daniw/xlr_pegelwandler/README.md

xlr_pegelwandler
================

Pegelwandler für den Anschluss von Tastern via XLR
