daniw/xlr_pegelwandler/doc/circuit.tex

% coding:utf-8

\section{Schaltung}

\subsection{Schema}
\begin{figure}[h!]
	\centering
	
	\caption{Schema}
	\label{sch:pegw}
\end{figure}

\subsection{Funktion}
Die beiden Kanäle sind identisch aufgebaut. Nachfolgend wird die Funktionsweise 
anhand der Teilschaltung 10x gezeigt. 

R101 fungiert als Pull-Up Widerstand. Um Störungen durch das lange Kabel des an 
CON101 angeschlossenen Tasters zu verringern ist dieser niederohmig 
ausgeführt. C101 filtert hochfrequente Störungen und stellt einen gewissen 
Schutz der Basis von V101 gegen ESD dar. V101 und V102 arbeiten als Schalter in 
Emitterschaltung. Im Ruhezustand sperren beide Transistoren. Das Ausgangssignal 
ist HIGH. Wird der Taster gedrückt, sinkt die Spannung am Eingang der 
Schaltung. Dadurch wird V101 leitend die Spannung am Kollektor von V101 steigt. 
Dies bewirkt, dass V102 leitend wird und die Ausgangsspannung LOW wird. Beim 
Loslassen des Tasters kehrt die Schaltung in ihren Ursprungszustand zurück. 

\subsubsection{Dimensionierung}
\[ \begin{array}{l}
R101 = \dfrac{U_B}{I_{sw}}\\
U_B = 6.6 V\\
I_{sw} = 20 mA\\
\Rightarrow R101 = \dfrac{6.6V}{20mA} = \underline{\underline{330 \Omega}}
\end{array} \]
\[ \begin{array}{l}
P_{R101} = \dfrac{{U_{R101}}^2}{R101} = \dfrac{{U_{Bat_{max}}}^2}{R101} 
= \dfrac{7.3 V}{330 \Omega} = 161 mW
\end{array} \]
Die Leistung an $R101$ ist am grössten, da die anderen Widerstände um 
Grössenordnungen hochohmiger sind. Für $R101$ wird ein SMD Widerstand der 
Baugrösse 1206 verwendet. Für alle anderen Widerstände genügt die Baugrösse 
0805. 
%
\[ \begin{array}{l}
R104 = \dfrac{5 V - U_{O_H}}{I_O} = \dfrac{5 V - 3 V}{0.2 mA} 
= \underline{\underline{10 k \Omega}}\\
\end{array} \]
%
\[ \begin{array}{l}
I_{B_{V102}} 
= \dfrac{I_{C_{V102}} \cdot ü}{\beta} 
= \dfrac{\dfrac{U_{cc} - U_{CE_{V102}}}{R104} \cdot ü}{\beta_{V102_{min}}} 
= \dfrac{\dfrac{5V - 0.2V}{10 k\Omega} \cdot 3}{110} = 11.73 \mu A\\\\
R103_{max} 
= \dfrac{U_{B_{min}} - U_{CE_{V101}} - U_{BE_{V102}}}{I_{B_{V102}}} 
= \dfrac{5 V - 0.2 V - 0.7 V}{11.73 \mu A} 
= 349.6 k \Omega\\\\
\rightarrow \underline{\underline{330 k\Omega}}
\end{array} \]
%
Für die Dimensionierung von $R105$ wird der Basisstrom vom $V102$ 
vernachlässigt. Als Kollektorstrom $I_{C_{V101}}$ werden $0.2 mA$ festgelegt. 
\[ \begin{array}{l}
R105_{max} 
= \dfrac{U_{B_{min}} - U_{CE_{V101}}}{I_{C_{V101}}} 
= \dfrac{5 V - 0.2 V}{0.2 mA} = \underline{\underline{24 k \Omega}}\\
\end{array} \]
%
\[ \begin{array}{l}
R102 
= \dfrac{U_{B_{min}} - U_{BE_{V101}}}{I_{B_{V101}}}\\\\
I_{B_{V101}} 
= \dfrac{I_{C_{V101}} \cdot ü}{\beta}\\\\
I_{C_{V101}} 
= I_{R105} + I_{R103} 
= \dfrac{U_{B_{min}} - U_{CE_{V101}}}{R105} 
+ \dfrac{U_{B_{min}} - U_{CE_{V101}} - U_{BE_{V102}}}{R103} \\\\
= \dfrac{5 V - 0.2 V}{24 k \Omega} + \dfrac{5 V - 0.2 V - 0.7 V}{330 k \Omega} 
= 0.2 mA + 12.42 \mu A 
= 212.42 \mu A \\\\
I_{B_{V101}} 
= \dfrac{212.42 \mu A \cdot 3}{125} 
= 5.098 \mu A \\\\
R102_{max} 
= \dfrac{5 V - 0.7 V}{0.298 \mu A} 
= 843.4 k \Omega 
\rightarrow \underline{\underline{820 k \Omega}}
\end{array} \]
%
$C101$ dient dazu, Störungen zu reduzieren. Dazu bildet er mit $R101$ zusammen 
einen Tiefpass. $R102$ kann für diese Betrachtung vernachlässigt werden. Als 
Grenzfrequenz $f_g$ wird willkürlich ein Wert von $5 kHz$ angenommen. 
\[ f_g = \dfrac{1}{2 \cdot \pi \cdot R101 \cdot C101} \]
\[ C101 = \dfrac{1}{2 \cdot \pi \cdot R101 \cdot f_g} 
= C101 = \dfrac{1}{2 \cdot \pi \cdot 330 \Omega \cdot 5 kHz} = 96.56 nF 
\rightarrow \underline{\underline{100 nF}} \]
