daniw/xlr_pegelwandler/doc/xlr_pegelwandler_main.tex

% coding:utf-8

%FOSAET, a LaTeX-Code for a electrical summary of basic electronics
%Copyright (C) 2013, Daniel Winz, Ervin Mazlagic

%This program is free software; you can redistribute it and/or
%modify it under the terms of the GNU General Public License
%as published by the Free Software Foundation; either version 2
%of the License, or (at your option) any later version.

%This program is distributed in the hope that it will be useful,
%but WITHOUT ANY WARRANTY; without even the implied warranty of
%MERCHANTABILITY or FITNESS FOR A PARTICULAR PURPOSE.  See the
%GNU General Public License for more details.
%----------------------------------------

\documentclass[a4paper,10pt,fleqn]{article}

\usepackage{xlr_pegelwandler_layout}

\title{Dokumentation XLR-Pegelwandler}

\author{Daniel Winz}
\date{\today~\dtc}

\begin{document}

\maketitle
\newpage
% \include{about}

\tableofcontents

\include{requirements}
\include{circuit}
\include{layout}
\include{bom}
\include{bestueck}
\include{test}

\end{document}
