daniw/xlr_pegelwandler/doc/bom.tex

% coding:utf-8

\section{Stückliste}

\subsection{Stückliste für eine Platine}
\STautoround*{2}
\begin{table}[h!]
  \begin{spreadtab}{{tabular}{@{}l@{}lllrr}}
    @ & @ Anzahl  & @ Bezeichnung & @ Bestellnummer & @ Einzelpreis & @ Gesamtpreis \\
    @ & @ \lbrack Stk\rbrack && @ (Distrelec) & @ \lbrack Fr.\rbrack & @ \lbrack Fr.\rbrack \\
    @ \rowcolor{lgray} & 1 & @ Platine                       & @          & 4.536& \STcopy{v}{b3*[-1,0]}\\
    @ \rowcolor{white} & 1 & @ Neutrik NC3MD-V               & @ 15 98 55 & 8.30 &  \\
    @ \rowcolor{lgray} & 2 & @ BC847A                        & @ 61 03 79 & 0.29 &  \\
    @ \rowcolor{white} & 2 & @ BC857A                        & @ 61 15 88 & 0.27 &  \\
    @ \rowcolor{lgray} & 2 & @ Widerstand 330 $\Omega$ 1206  & @ 71 12 86 & 0.089&  \\
    @ \rowcolor{white} & 2 & @ Widerstand 10 k$\Omega$ 0805  & @ 71 33 18 & 0.069&  \\
    @ \rowcolor{lgray} & 2 & @ Widerstand 24 k$\Omega$ 0805  & @ 71 33 27 & 0.069&  \\
    @ \rowcolor{white} & 2 & @ Widerstand 330 k$\Omega$ 0805 & @ 71 33 54 & 0.069&  \\
    @ \rowcolor{lgray} & 2 & @ Widerstand 820 k$\Omega$ 0805 & @ 71 33 64 & 0.069&  \\
    @ \rowcolor{white} & 2 & @ Kondensator 100 nF 0805       & @ 83 14 69 & 0.15 &  \\
    @ \rowcolor{lgray} & 1 & @ Stiftleiste Dubox 5p Pol      & @ 11 67 33 & 1.70 &  \\
    @ \rowcolor{white} & 1 & @ Buchsengehäuse Dubox 5 Pol    & @ 11 67 03 & 1.10 &  \\
    @ \rowcolor{lgray} & 5 & @ Crimpkontakt Dubox            & @ 11 67 29 & 0.70 &  \\
    @ \rowcolor{white} & 2 & @ Senkkopfschraube M3 x 12      & @ 34 32 38 & 0.185 &  \\
    @ \rowcolor{lgray} & 2 & @ Mutter M3                     & @ 34 82 75 & 0.153&  \\
    @ \rowcolor{white} & 2 & @ Fächerscheibe für M3          & @ 34 82 48 & 0.098&  \\&&&&\\
    @ \rowcolor{white} &   & @ Total                         & @          &      & :={sum(f3:[0,-2])}\\
    \cline{6-6}
    \cline{6-6}
  \end{spreadtab}
\end{table}

\newpage
\subsection{Stückliste für gesamtes Gerät}
% Diese Stückliste ist die Empfehlung für die Bestellung. 
% Dabei sind Reserven für SMD-Bauteile und die Crimpkontakte berücksichtigt. \\
% Auch in dieser Stückliste ist das Gehäuse nur ein Vorschlag, da die benötigten 
% Abmessungen nicht bekannt sind. 
\STautoround*{2}
\begin{table}[h!]
  \begin{spreadtab}{{tabular}{@{}l@{}lllrr}}
    @ & @ Anzahl  & @ Bezeichnung & @ Bestellnummer & @ Einzelpreis & @ Gesamtpreis \\
    @ & @ \lbrack Stk\rbrack && @ (Distrelec) & @ \lbrack Fr.\rbrack & @ \lbrack Fr.\rbrack \\
    @ \rowcolor{lgray} & 1 & @ Gehäuse Fibox ABS100/75 LT    & @ 30 29 93 & 12.10& \STcopy{v}{b3*[-1,0]}\\
    @ \rowcolor{white} & 2 & @ Platine                       & @          & 4.536&  \\
    @ \rowcolor{lgray} & 2 & @ Neutrik NC3MD-V               & @ 15 98 55 & 8.30 &  \\
    @ \rowcolor{white} & 5 & @ BC847A                        & @ 61 03 79 & 0.29 &  \\
    @ \rowcolor{lgray} & 5 & @ BC857A                        & @ 61 15 88 & 0.27 &  \\
    @ \rowcolor{white} & 5 & @ Widerstand 330 $\Omega$ 1206  & @ 71 12 86 & 0.089&  \\
    @ \rowcolor{lgray} & 5 & @ Widerstand 10 k$\Omega$ 0805  & @ 71 33 18 & 0.069&  \\
    @ \rowcolor{white} & 5 & @ Widerstand 24 k$\Omega$ 0805  & @ 71 33 27 & 0.069&  \\
    @ \rowcolor{lgray} & 5 & @ Widerstand 330 k$\Omega$ 0805 & @ 71 33 54 & 0.069&  \\
    @ \rowcolor{white} & 5 & @ Widerstand 820 k$\Omega$ 0805 & @ 71 33 64 & 0.069&  \\
    @ \rowcolor{lgray} & 5 & @ Kondensator 100 nF 0805       & @ 83 14 69 & 0.15 &  \\
    @ \rowcolor{white} & 2 & @ Stiftleiste Dubox 5p Pol      & @ 11 67 33 & 1.70 &  \\
    @ \rowcolor{lgray} & 2 & @ Buchsengehäuse Dubox 5 Pol    & @ 11 67 03 & 1.10 &  \\
    @ \rowcolor{white} &15 & @ Crimpkontakt Dubox            & @ 11 67 29 & 0.70 &  \\
    @ \rowcolor{lgray} & 4 & @ Senkkopfschraube M3 x 12      & @ 34 32 38 & 0.185 &  \\
    @ \rowcolor{white} & 4 & @ Mutter M3                     & @ 34 82 75 & 0.153&  \\
    @ \rowcolor{lgray} & 4 & @ Fächerscheibe für M3          & @ 34 82 48 & 0.098&  \\&&&&\\
    @ \rowcolor{white} &   & @ Total                         & @          &      & :={sum(f3:[0,-2])}\\
    \cline{6-6}
    \cline{6-6}
  \end{spreadtab}
\end{table}
