daniw/xlr_pegelwandler/doc/fig/xlr_pegelwandler_v_1_2_best_eagle.pdf

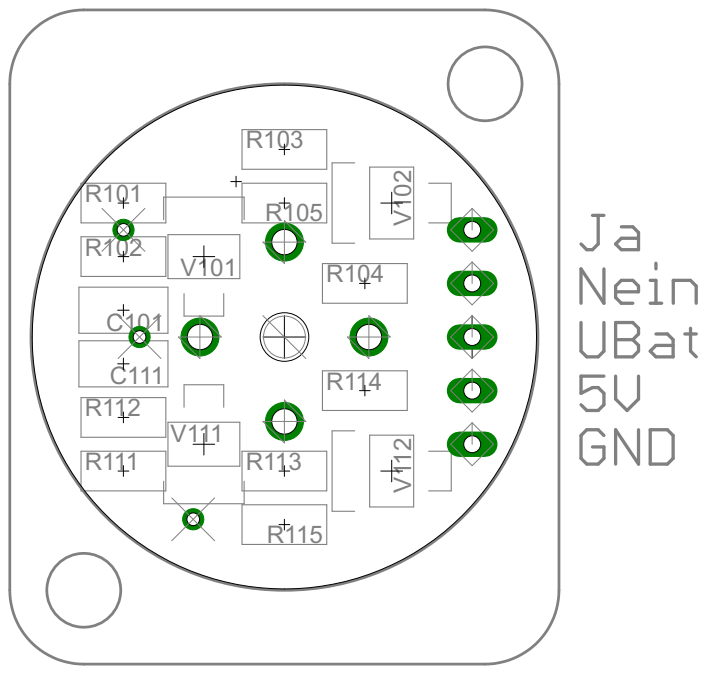
[picture p1: page 1]
