daniw/xlr_pegelwandler/doc/fig/xlr_pegelwandler_v_1_2_lay.pdf

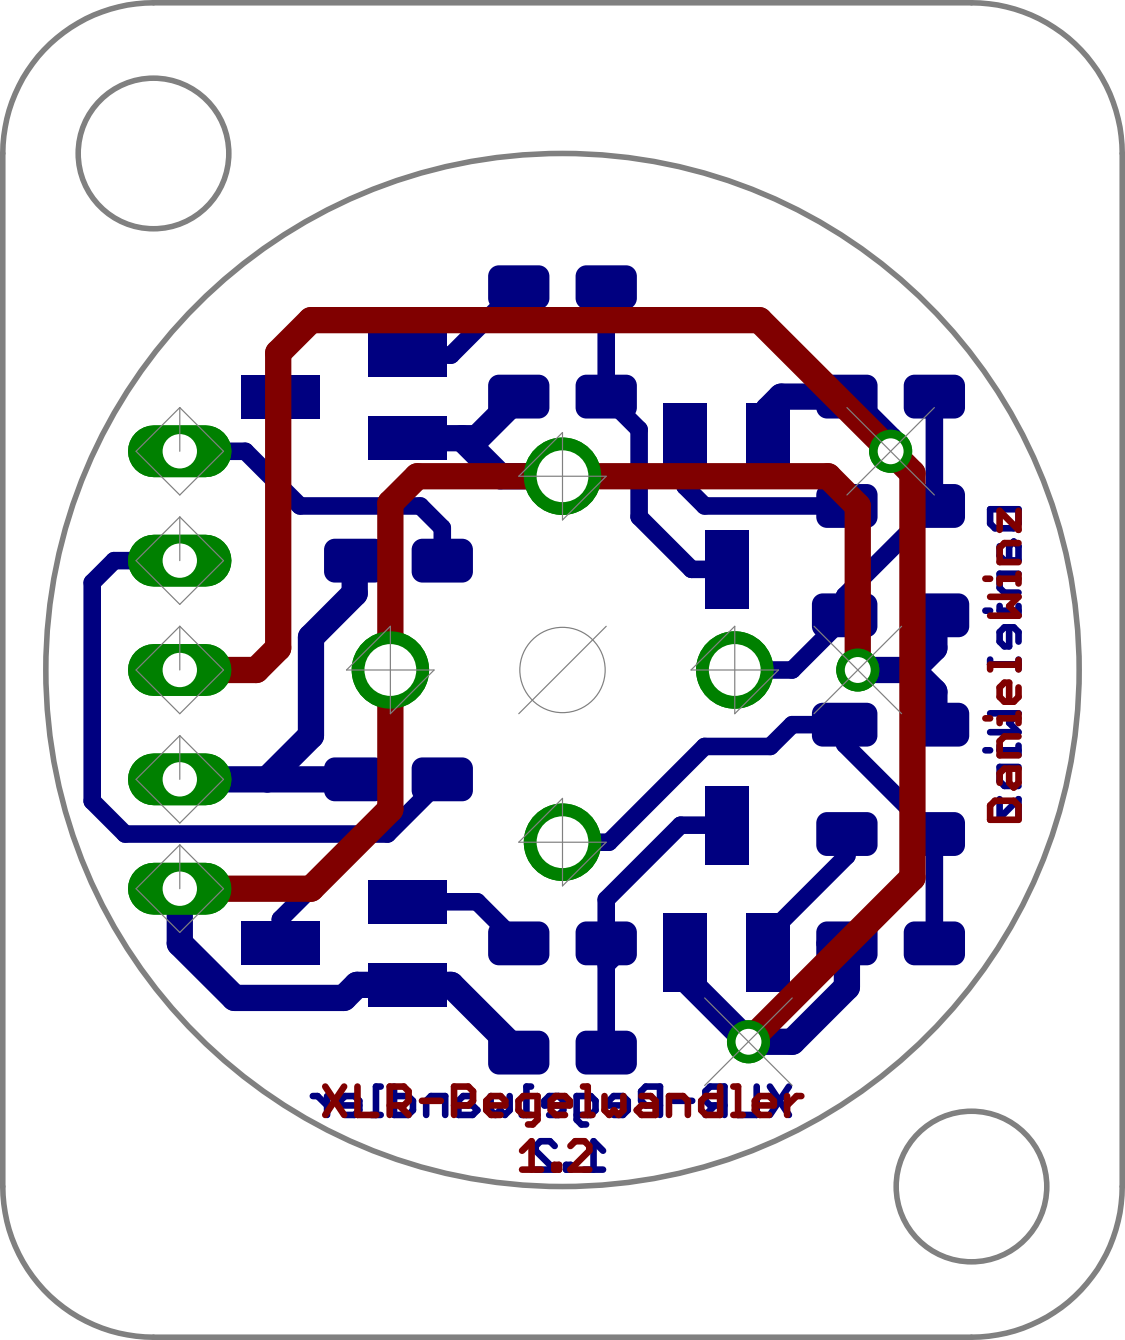
[picture p2: page 1]
