daniw/xlr_pegelwandler/doc/fig/xlr_pegelwandler_v_1_2_lay_eagle.pdf

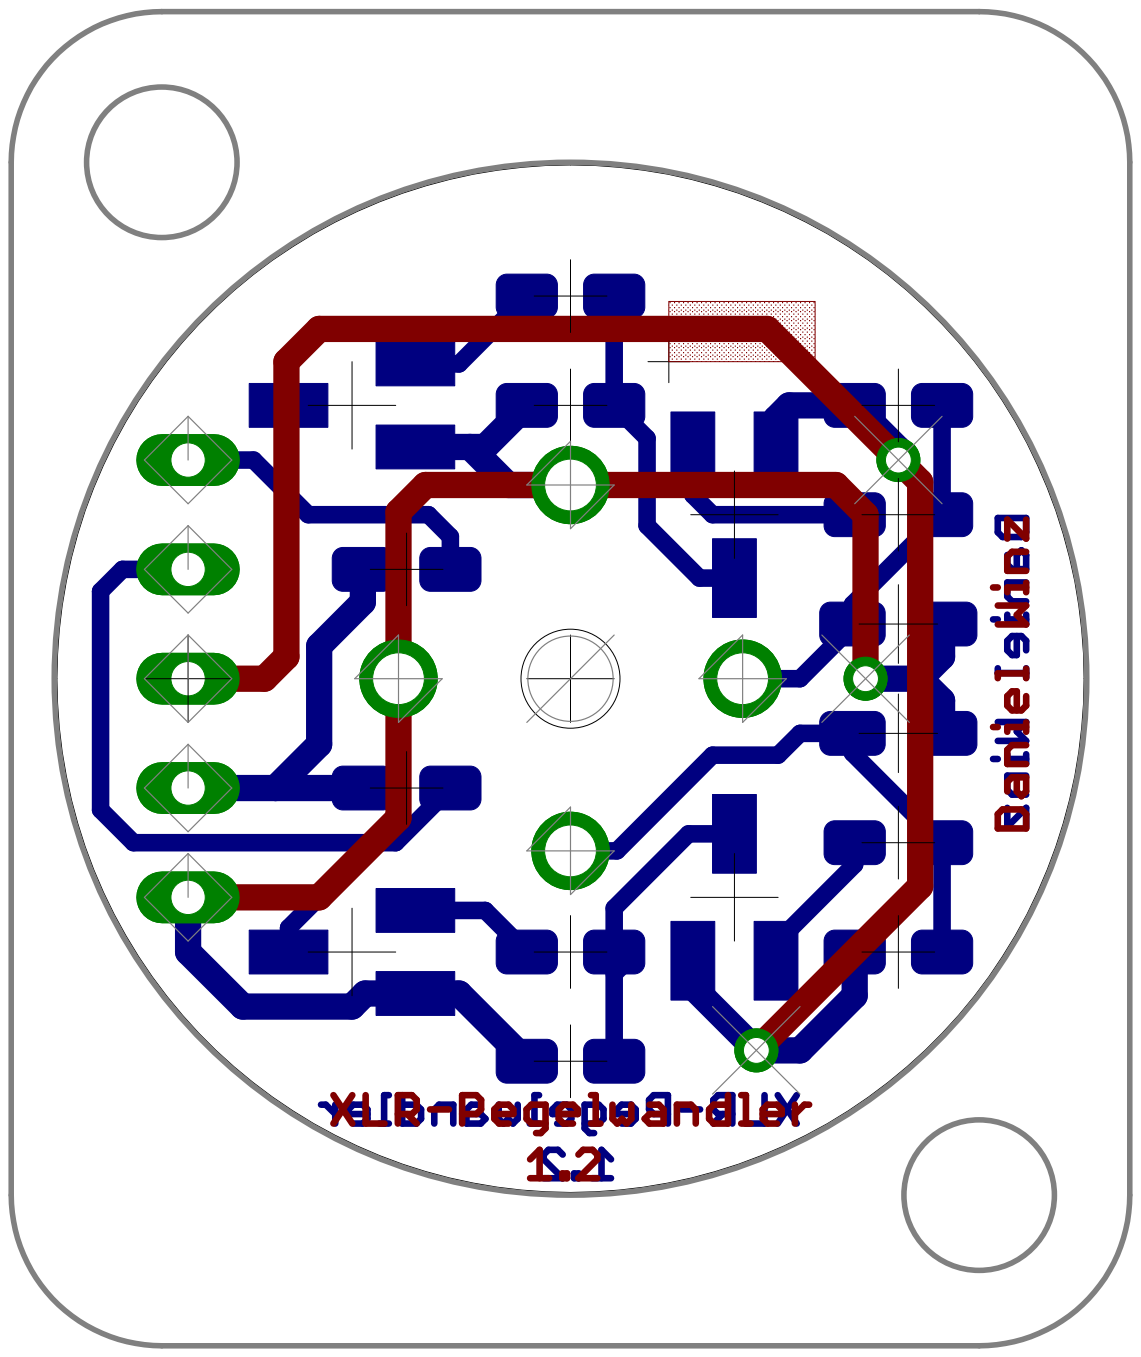
[picture p3: page 1]
