daniw/xlr_pegelwandler/doc/fig/xlr_pegelwandler_v_1_2_lay_transp.pdf

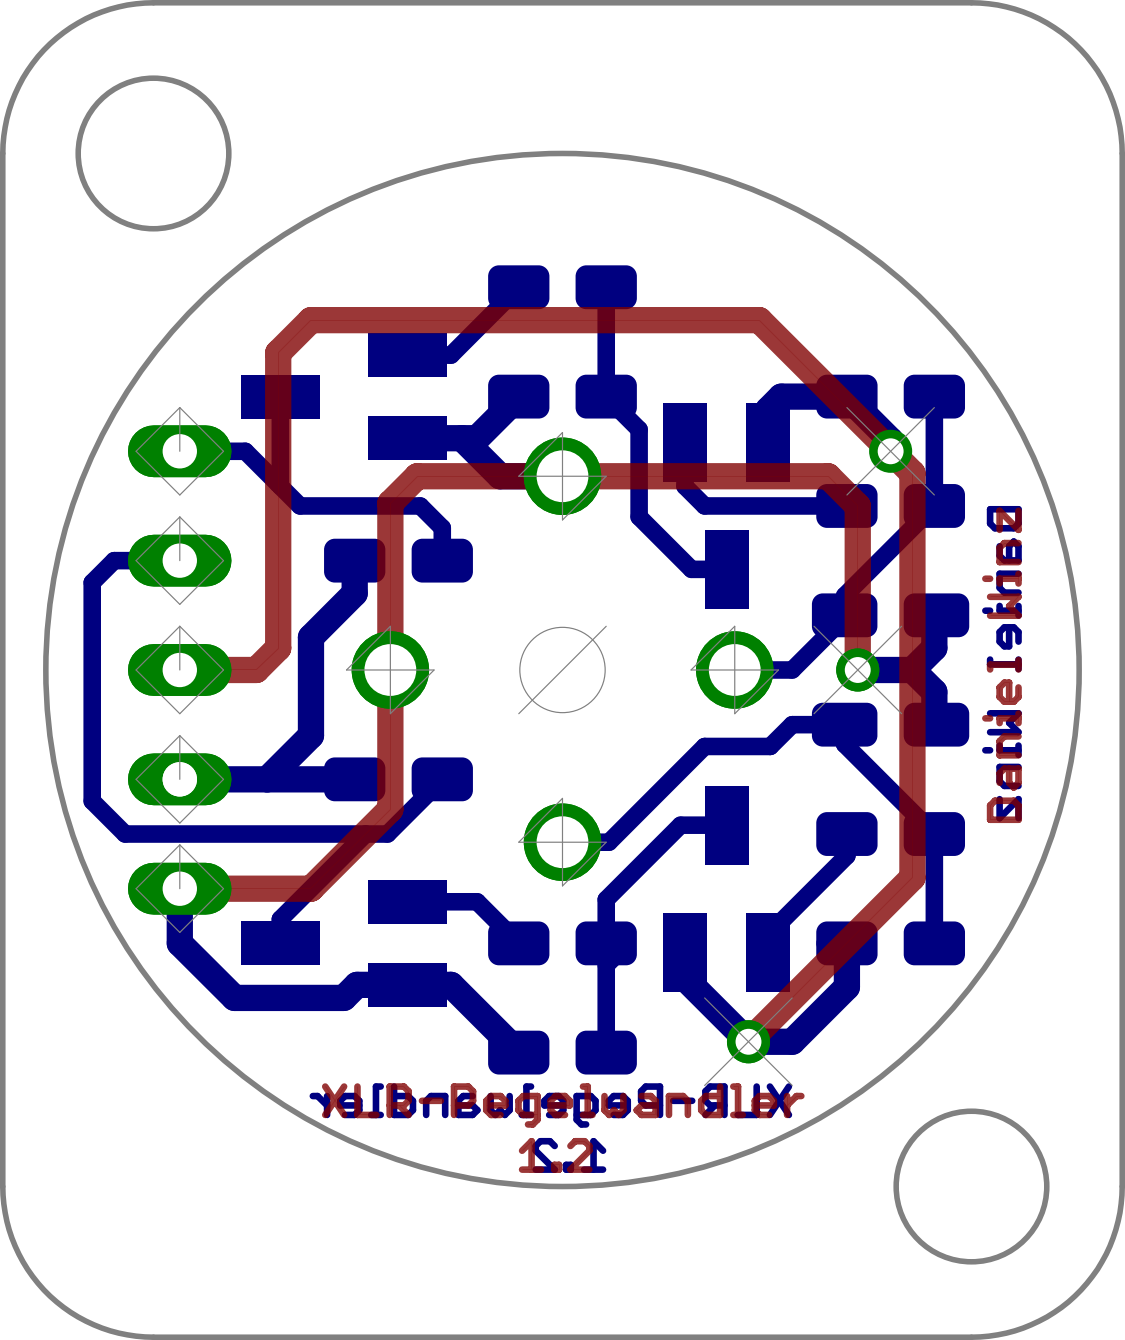
[picture p4: page 1]
