daniw/xlr_pegelwandler/doc/fig/xlr_pegelwandler_v_1_2_sch.pdf

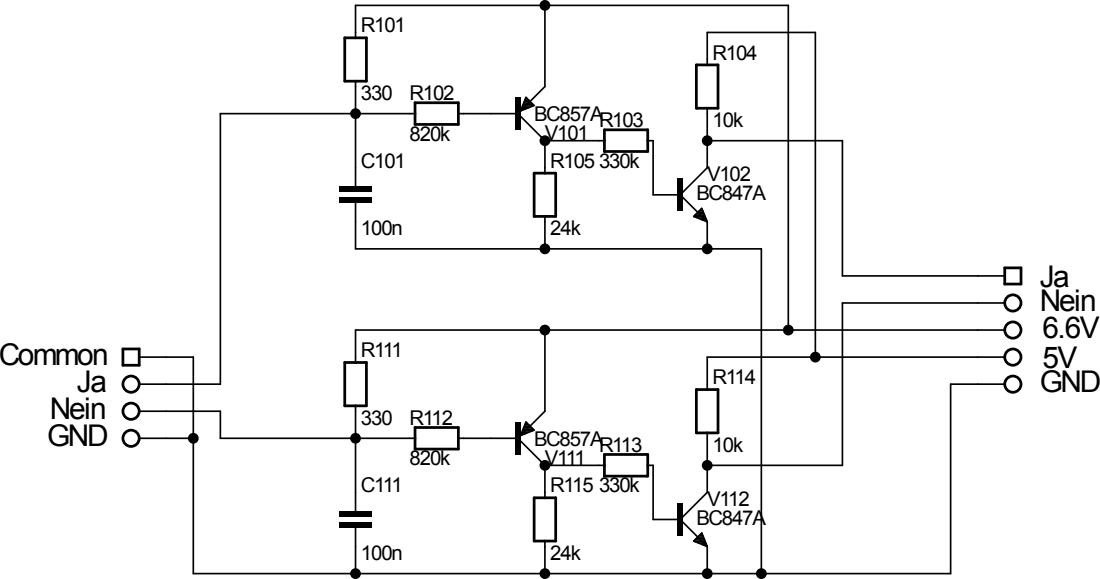
[picture p5: page 1]
