daniw/xlr_pegelwandler/doc/fig/xlr_pegelwandler_v_1_2_sch_eagle.pdf

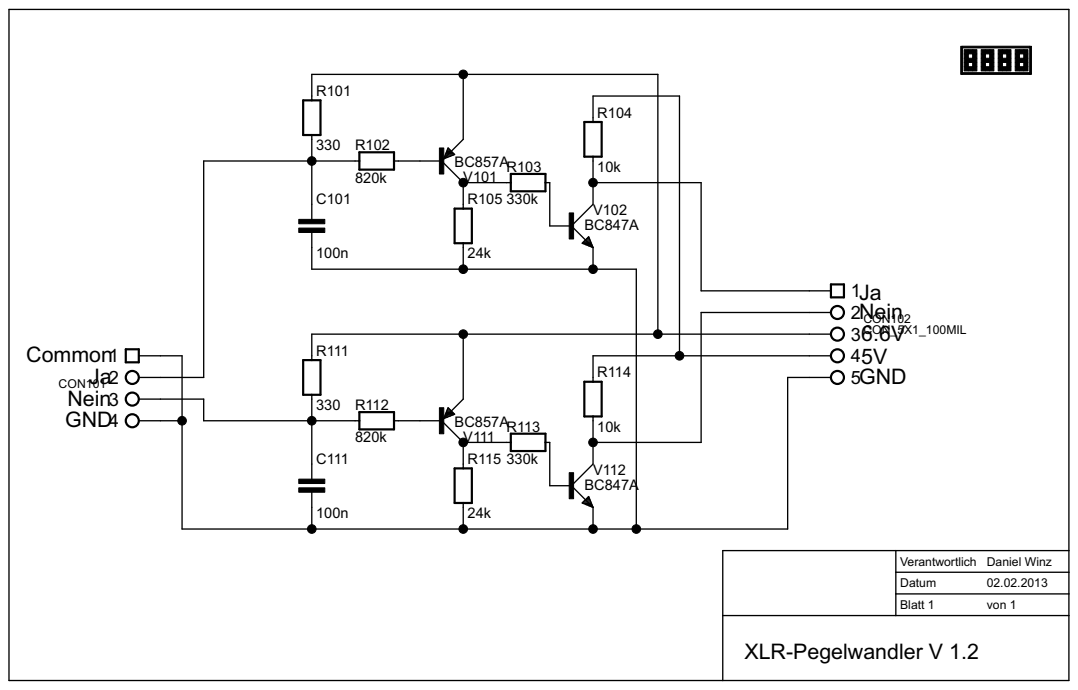
[picture p6: page 1]
