daniw/xlr_pegelwandler/doc/fig/xlr_pegelwandler_v_1_1_lay.pdf

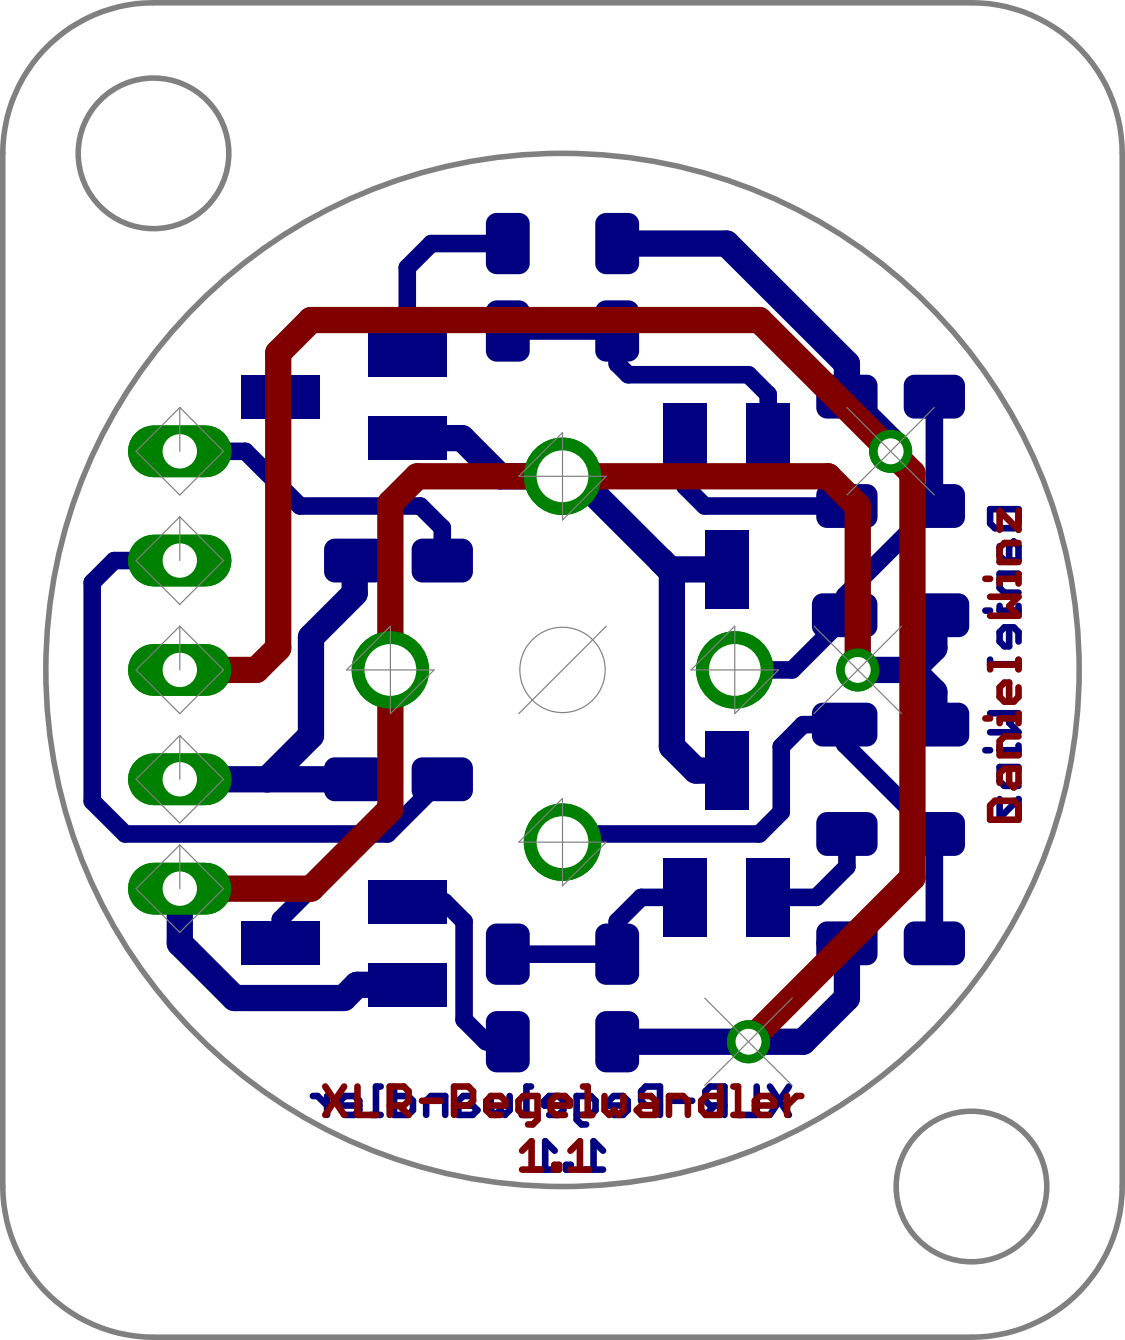
[picture p7: page 1]
