daniw/xlr_pegelwandler/doc/fig/xlr_pegelwandler_v_1_1_lay_transp.pdf

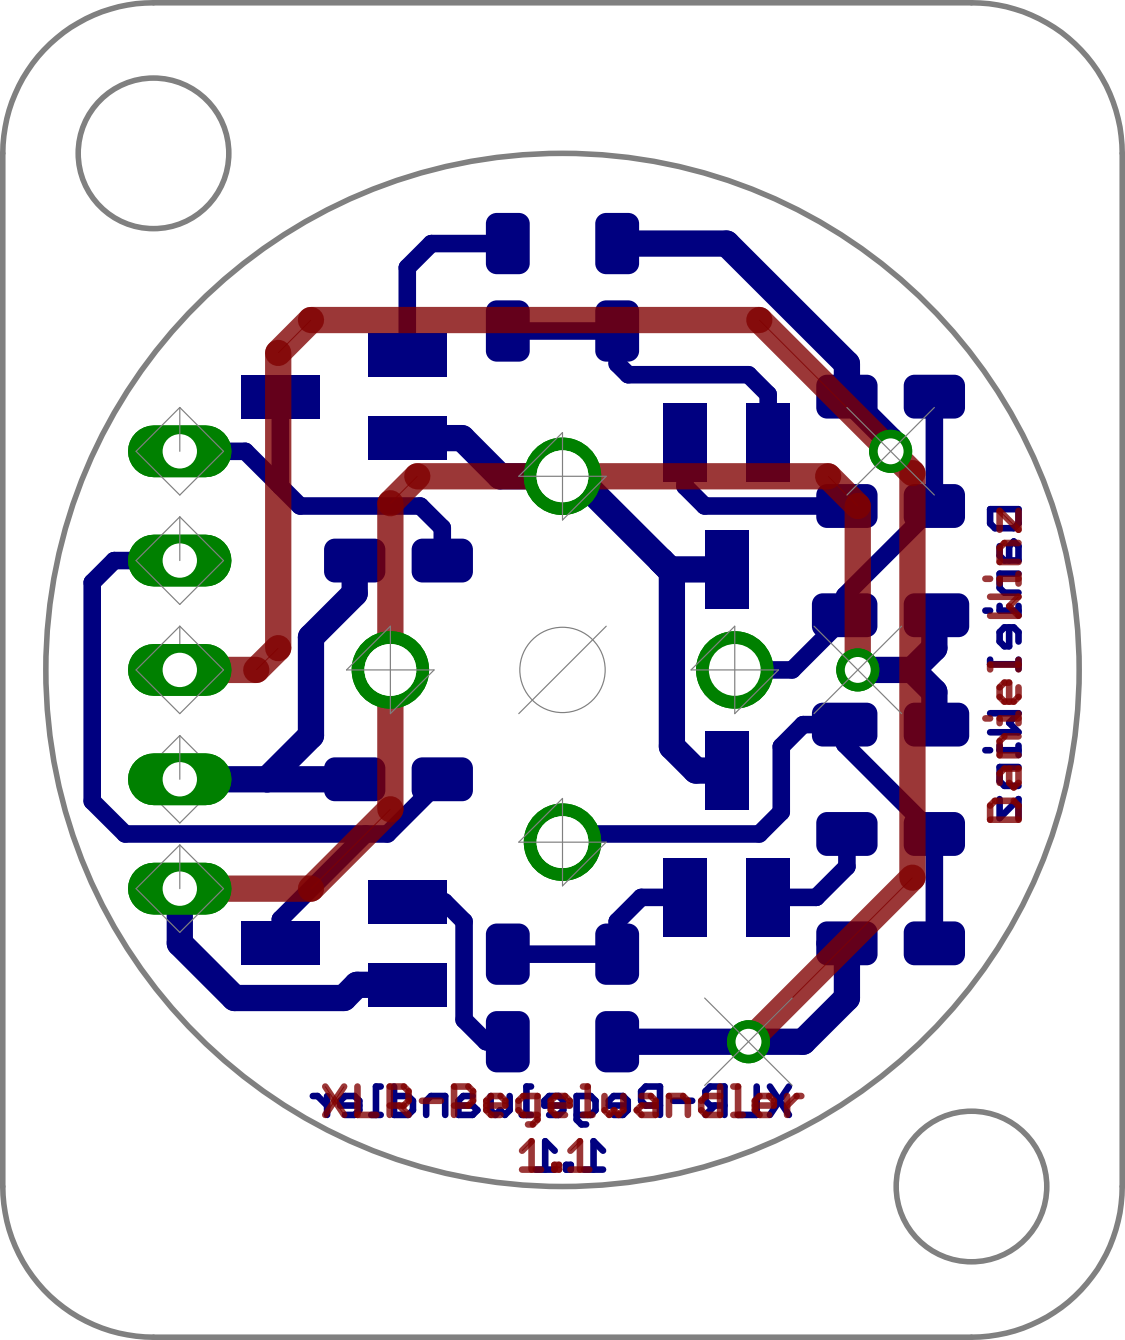
[picture p8: page 1]
