daniw/xlr_pegelwandler/doc/fig/xlr_pegelwandler_v_1_1_sch.pdf

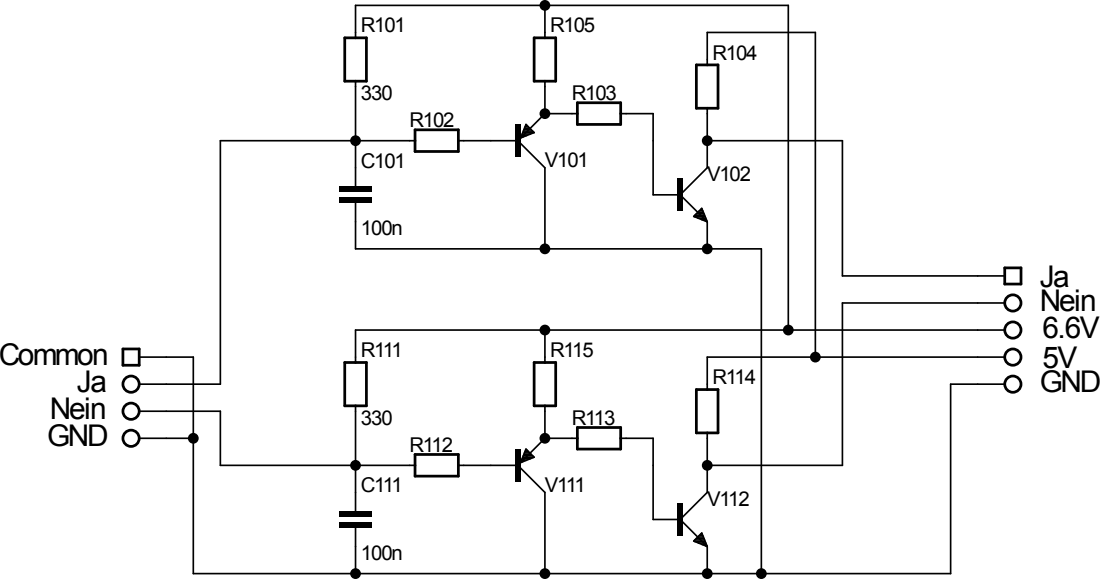
[picture p9: page 1]
