daniw/xlr_pegelwandler/doc/fig/xlr_pegelwandler_v_1_1_sch_eagle.pdf

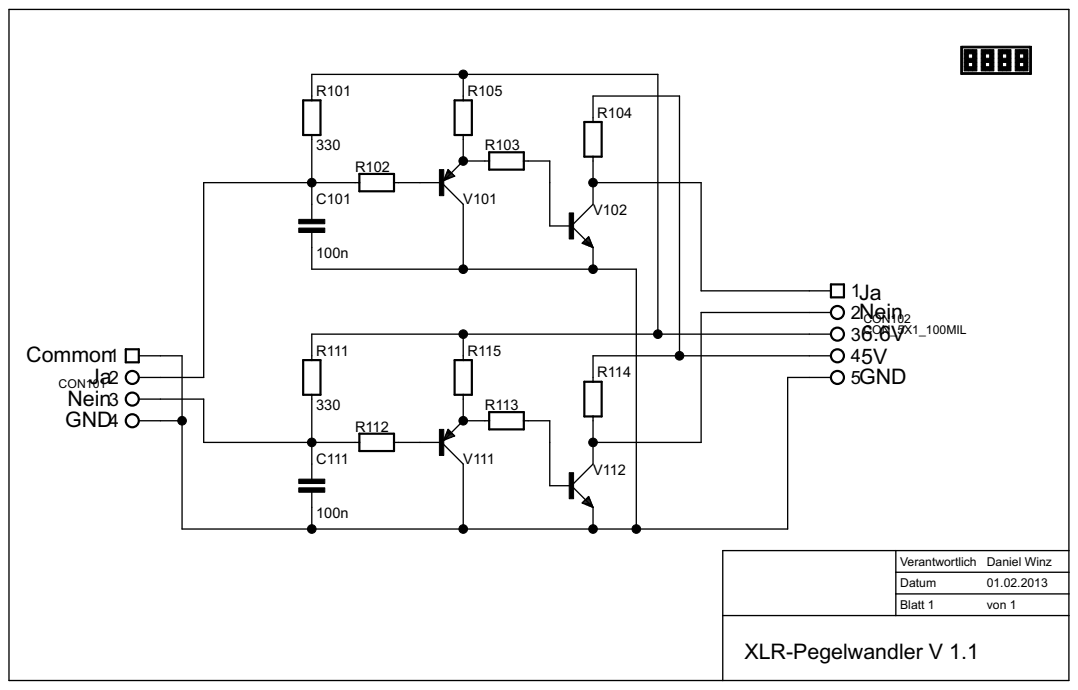
[picture p10: page 1]
