daniw/xlr_pegelwandler/doc/fig/xlr_pegelwandler_v_1_1_lay_eagle.pdf

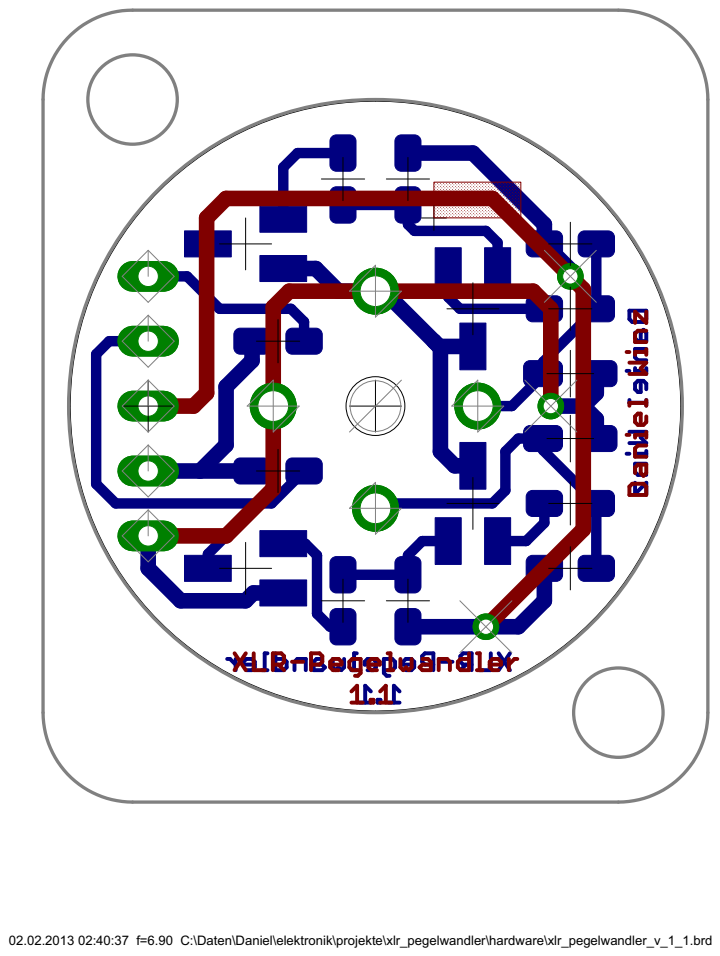
[picture p11: page 1]

02.02.2013 02:40:37 f=6.90 C:\Daten\Daniel\elektronik\projekte\xlr_pegelwandler\hardware\xlr_pegelwandler_v_1_1.brd
