daniw/xlr_pegelwandler/hardware/sim/xlr_pegelwandler_v_1_2.asc

C1: cap; 100n
Q1: npn; BC847A
Q2: pnp; BC857A
R1: res; 330k
R2: res; 820k
R3: res; 330
R4: res; 24k
R5: res; 10k
S1: sw; switch
V1: voltage; PULSE(0 1 1 1n 1n 50u 100u 10)
V2: voltage; 6.6
V3: voltage; 5
Named nets: 0, Out, ctrl, In
.model switch SW(Ron=10 Roff=1G Vt=0.5 Vh=-.1)
.tran 0 1.0002 0.9999
