daniw/xlr_pegelwandler/hardware/xlr_pegelwandler_v_1_2.brd

## EAGLE design hardware/xlr_pegelwandler_v_1_2.brd (2013-07-05)

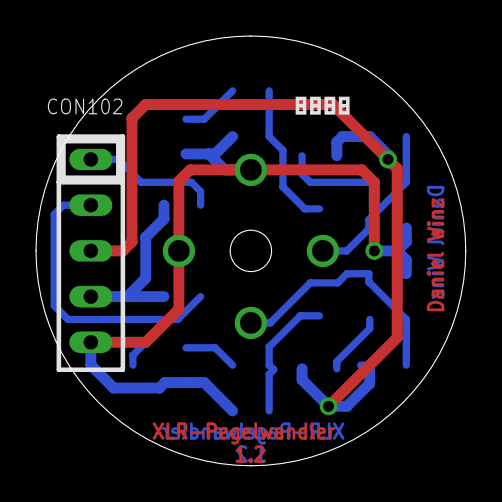
[picture p12: board xlr_pegelwandler_v_1_2.brd from above]

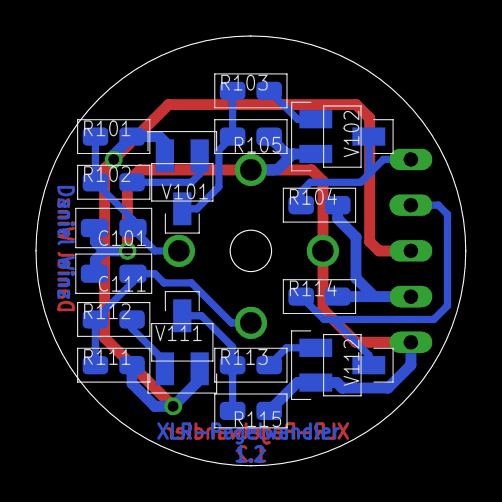
[picture p13: board xlr_pegelwandler_v_1_2.brd from below]

Board: 2 copper layers, 23.9 x 23.9 mm, 19 parts (16 on the bottom side), 13 nets.

Parts:
C101, C111: 100n; C_0805
CON101: XLR_NC3MD-V_NEUTRIK
CON102: CON_5X1_100MIL
R101, R111: 330; R_0805
R102, R112: 820k; R_0805
R103, R113: 330k; R_0805
R104, R114: 10k; R_0805
R105, R115: 24k; R_0805
U$1: LP_NUMBER08_SILK_TOP; LP_NUMBER_SILK_TOP
V101, V111: BC857A; SOT23
V102, V112: BC847A; SOT23

Connections:
CON101: C101.P$1, CON101.2, R101.P$1, R102.P$1
unnamed: R103.P$2, V102.1
unnamed: R113.P$2, V112.1
unnamed: CON102.P$2, R114.P$1, V112.3
unnamed: CON102.P$1, R104.P$1, V102.3
unnamed: R102.P$2, V101.1
unnamed: R103.P$1, R105.P$2, V101.3
unnamed: R113.P$1, R115.P$2, V111.3
unnamed: CON102.P$3, R101.P$2, R111.P$2, V101.2, V111.2
unnamed: R112.P$2, V111.1
unnamed: C111.P$1, CON101.3, R111.P$1, R112.P$1
unnamed: CON102.P$4, R104.P$2, R114.P$2
V102: C101.P$2, C111.P$2, CON101.1, CON101.G, CON102.P$5, R105.P$1, R115.P$1, V102.2, V112.2
