daniw/xlr_pegelwandler/(commit log)

2013-02-01 Schema und Layout
    [xlr_pegelwandler_v_1_0.brd, xlr_pegelwandler_v_1_0.sch]
2013-02-01 Korrektur in Schema und Layout
    [xlr_pegelwandler_v_1_1.brd, xlr_pegelwandler_v_1_1.sch]
2013-02-02 Schema und Layout als pdf
2013-02-02 Schema und Layout für Doku
2013-02-02 Korrektur Schema und Layout
    [xlr_pegelwandler_v_1_2.brd, xlr_pegelwandler_v_1_2.sch]
2013-02-03 Schema und Layout in Dok aktualisiert
2013-02-06 Schema und Layout: Bauteilwerte eingetragen
    [xlr_pegelwandler_v_1_2.brd, xlr_pegelwandler_v_1_2.sch]
2013-07-05 Steckerbelegung eingetragen
    [xlr_pegelwandler_v_1_2.brd]
2013-07-05 Schema ebenfalls auf neues Dateiformat konvertiert
    [xlr_pegelwandler_v_1_2.sch]
